alex-sage/pyroPCB/datasheets/arduino_mega_pro_1.webp

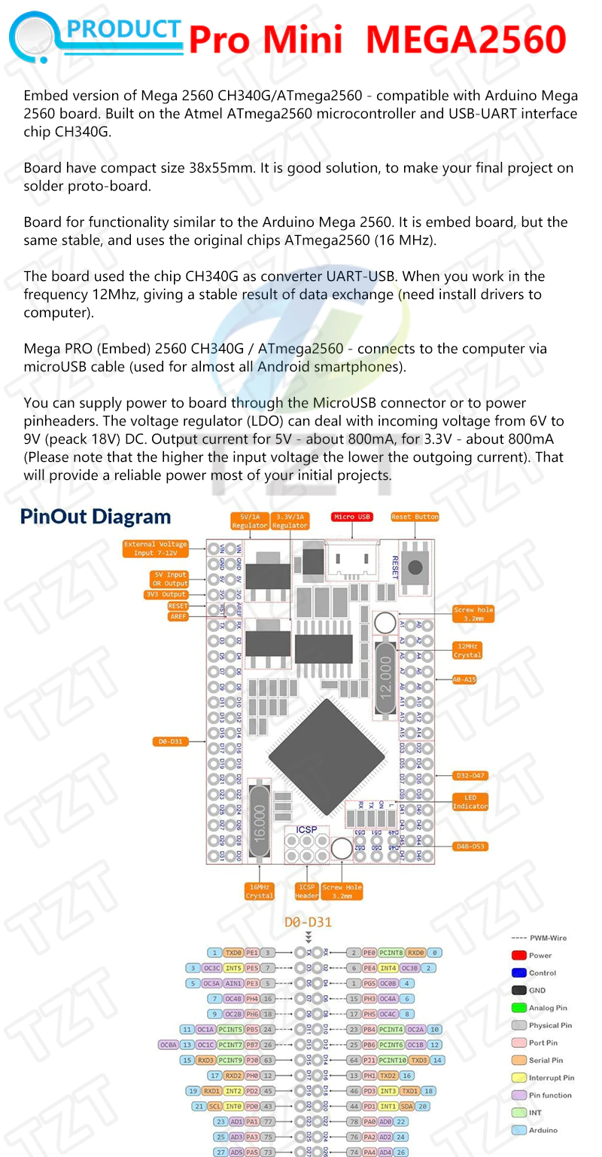
datasheets/arduino_mega_pro_1.webp
