alex-sage/pyroPCB/datasheets/arduino_mega_pro_2.webp

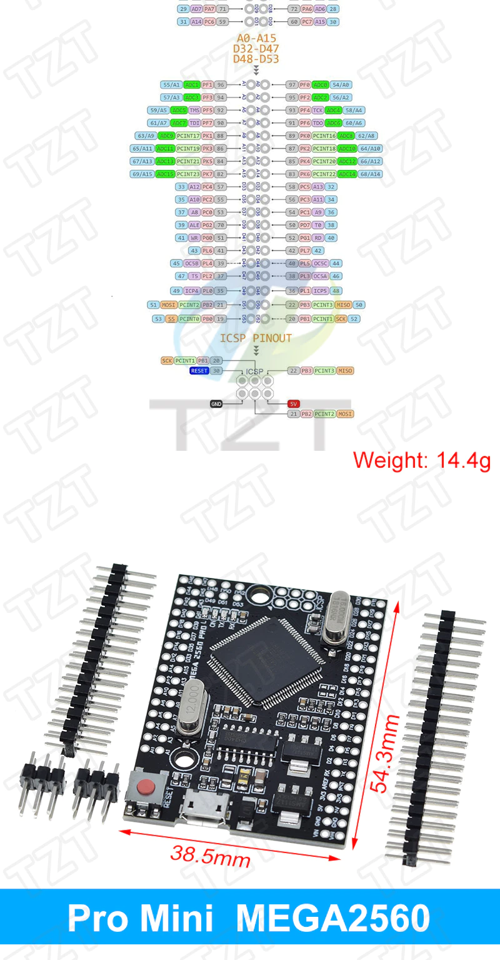
datasheets/arduino_mega_pro_2.webp
