alex-sage/pyroPCB/datasheets/arduino_mega_pro_3.webp

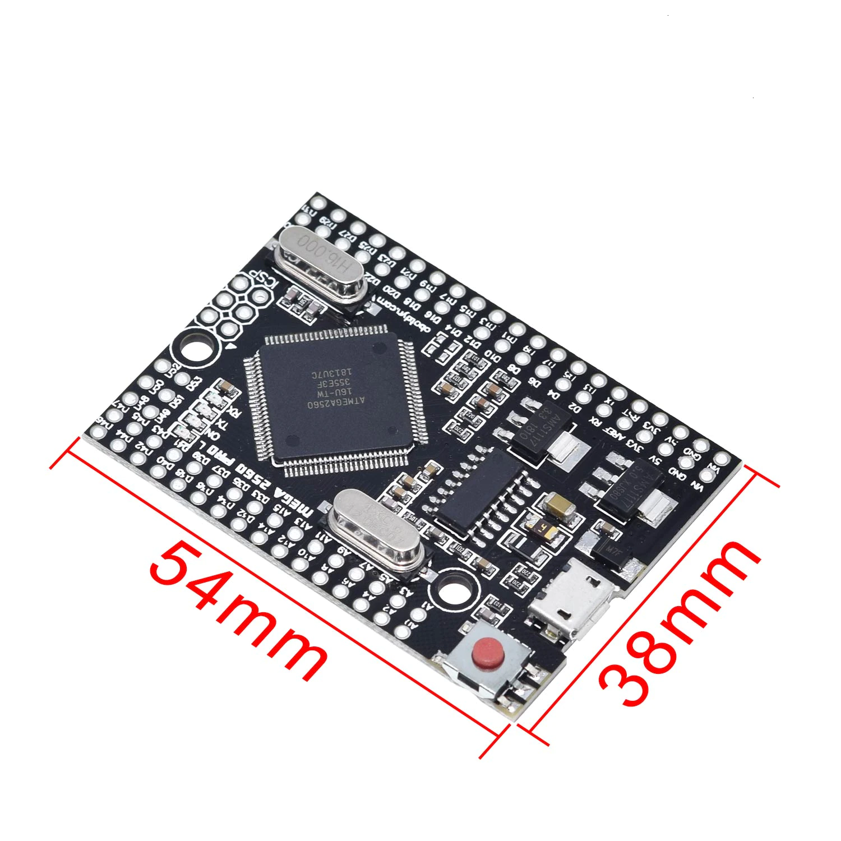
datasheets/arduino_mega_pro_3.webp
