alex-sage/pyroPCB/datasheets/salecom_t-80s_switch.gif

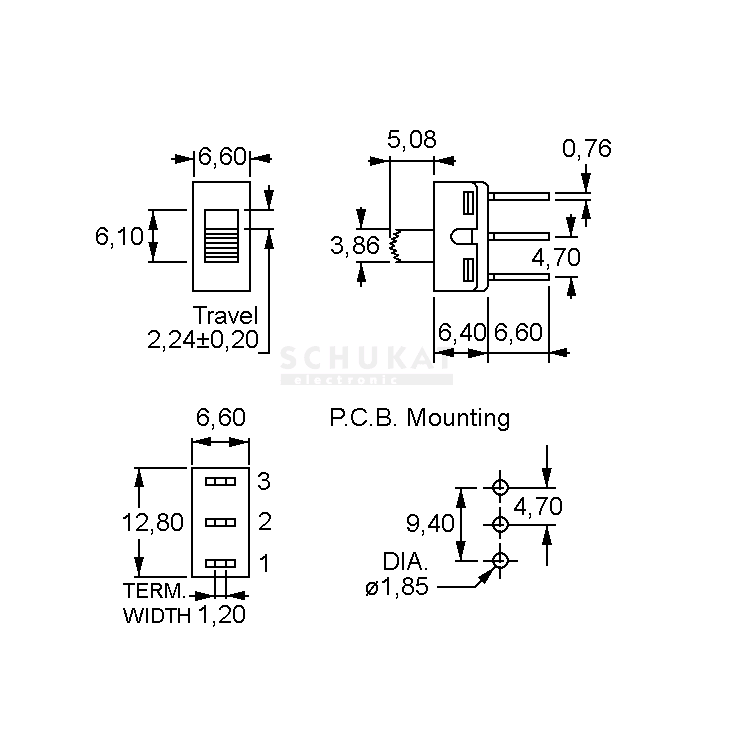
datasheets/salecom_t-80s_switch.gif
