alex-sage/pyroPCB/input-panel/TL1105DF160Q/TL1105DF160Q.step

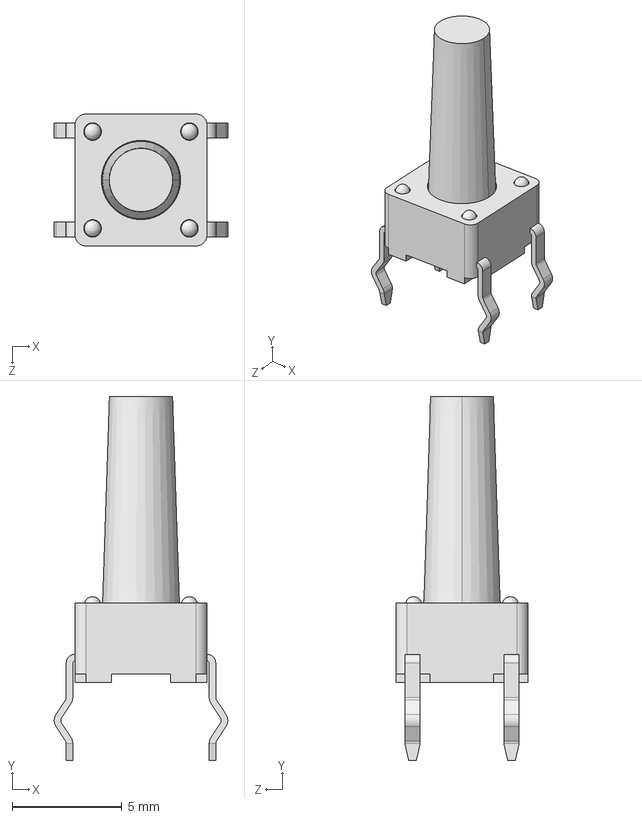
[picture p5: CAD file, 2023-02-28]
input-panel/TL1105DF160Q/TL1105DF160Q.step
7.89 x 16.6 x 6.00 mm
