alex-sage/pyroPCB/pyroDirector/components/cui-2.5mm-jack/CUI_DEVICES_SJ1-2503A.step

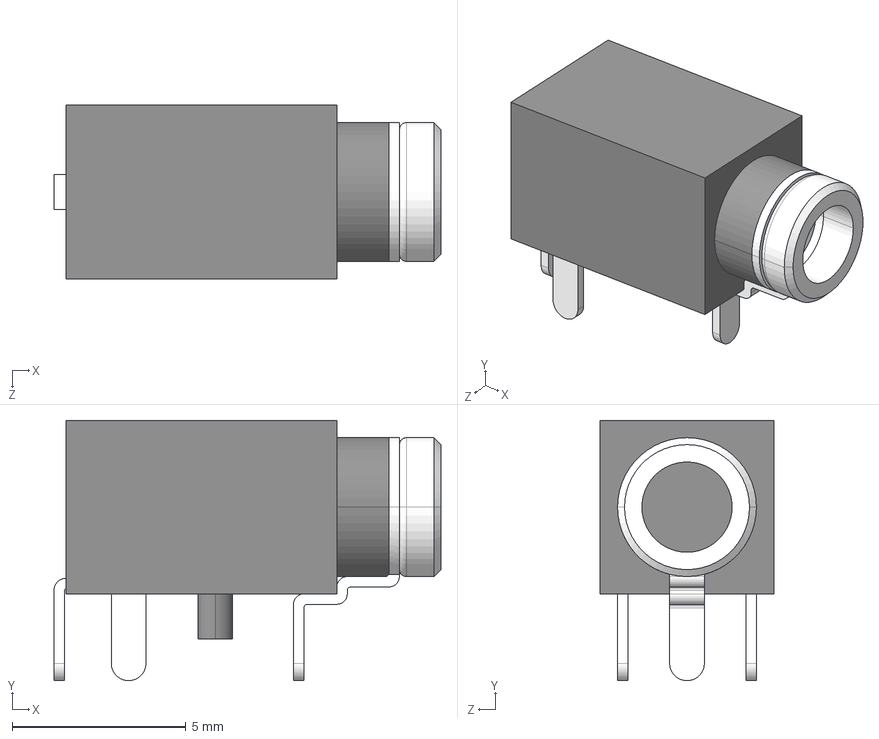
[picture p6: CAD file, 2023-02-11]
pyroDirector/components/cui-2.5mm-jack/CUI_DEVICES_SJ1-2503A.step
11.2 x 7.50 x 5.00 mm
