alex-sage/pyroPCB/pyroDirector/components/cui-3.5mm-3d/CUI_DEVICES_SJ1-3535NG.step

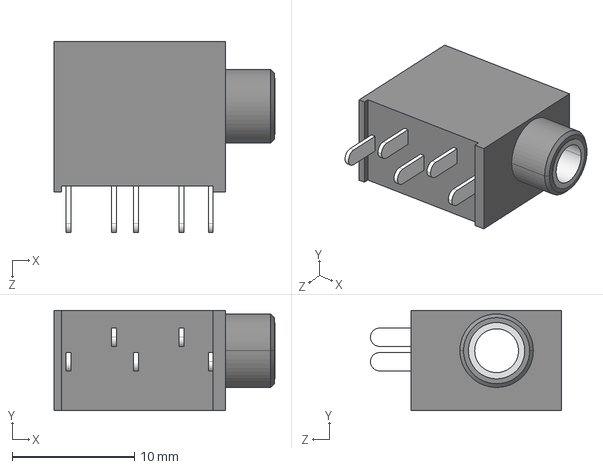
[picture p7: CAD file, 2023-02-11]
pyroDirector/components/cui-3.5mm-3d/CUI_DEVICES_SJ1-3535NG.step
18.1 x 8.20 x 15.6 mm
