alex-sage/pyroPCB/pyroDirector/components/songle-relays/SRD-05VDC-SL-C.step

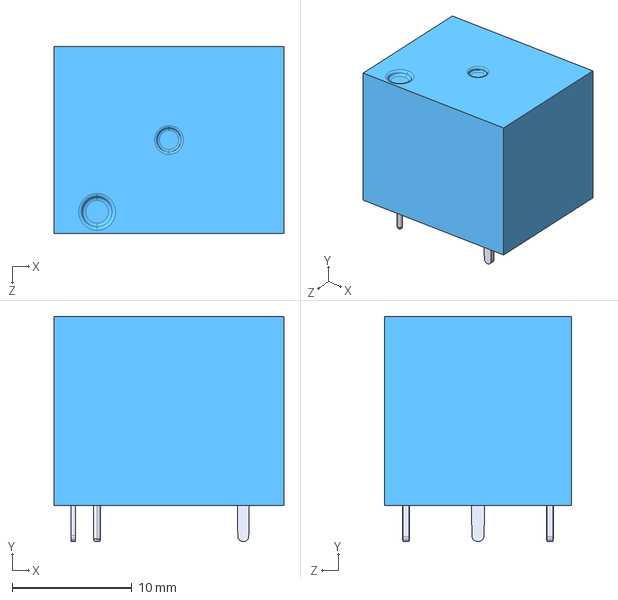
[picture p8: CAD file, 2023-01-26]
pyroDirector/components/songle-relays/SRD-05VDC-SL-C.step
19.2 x 18.8 x 15.6 mm
