alex-sage/pyroPCB/pyroDirector/components/TS-1187A-B-A-B/TS-1187A-B-A-B.step

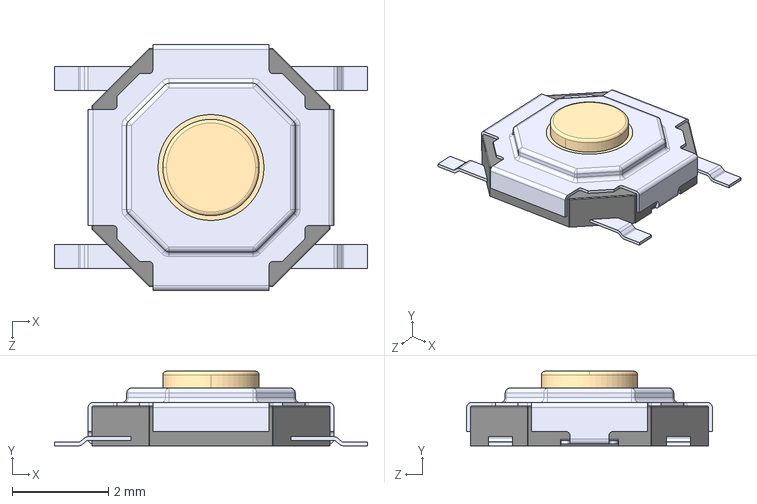
[picture p9: CAD file, 2023-01-26]
pyroDirector/components/TS-1187A-B-A-B/TS-1187A-B-A-B.step
6.50 x 1.55 x 5.10 mm
