alex-sage/pyroPCB/input-panel/TL1105DF160Q/TL1105DF160Q_E-Switch.pdf

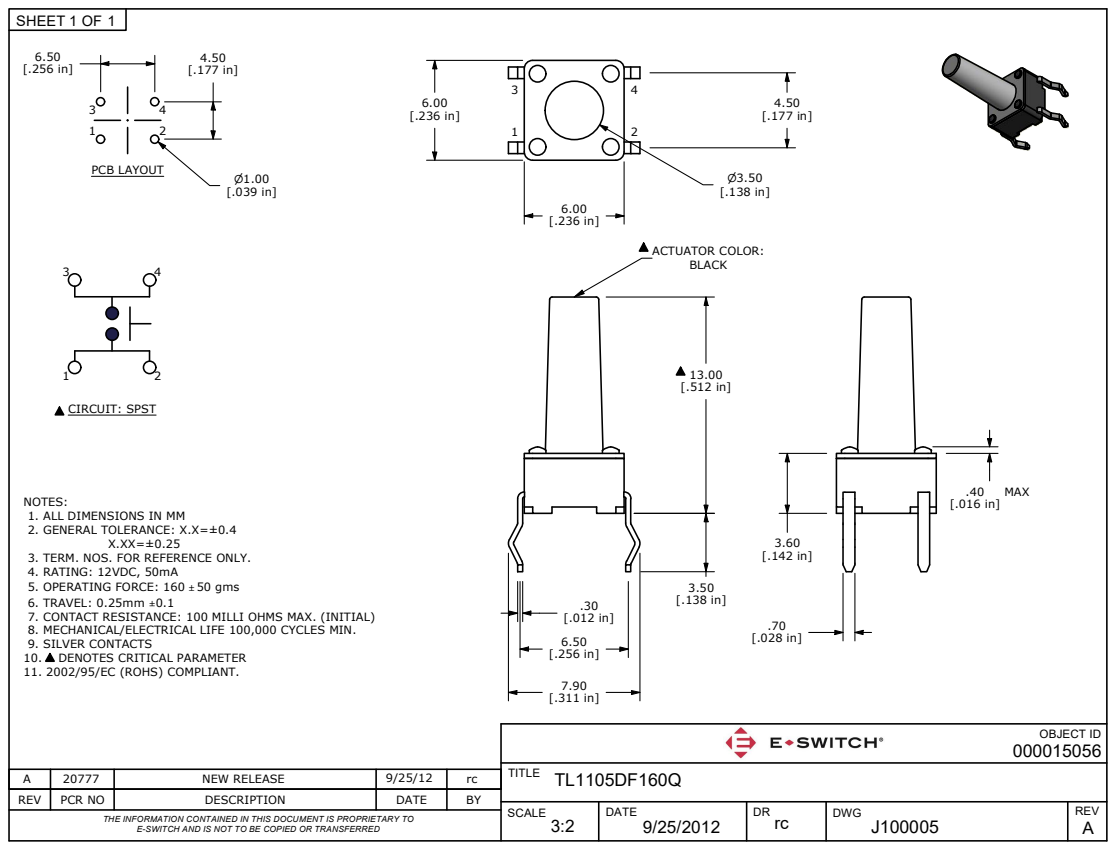
[picture p10: page 1]
REV; PCR NO; DESCRIPTION; DATE; OBJECT ID; PCB LAYOUT; NEW RELEASE; ACTUATOR COLOR:; CIRCUIT: SPST

NOTES:
1. ALL DIMENSIONS IN MM
2. GENERAL TOLERANCE: X.X=±0.4

3. TERM. NOS. FOR REFERENCE ONLY.
4. RATING: 12VDC, 50mA
5. OPERATING FORCE: 160 50 gms
6. TRAVEL: 0.25mm ±0.1
7. CONTACT RESISTANCE: 100 MILLI OHMS MAX. (INITIAL)
8. MECHANICAL/ELECTRICAL LIFE 100,000 CYCLES MIN.
9. SILVER CONTACTS
10. DENOTES CRITICAL PARAMETER
11. 2002/95/EC (ROHS) COMPLIANT.

THE INFORMATION CONTAINED IN THIS DOCUMENT IS PROPRIETARY TO

E-SWITCH AND IS NOT TO BE COPIED OR TRANSFERRED
