alex-sage/pyroPCB/input-panel/input-panel.kicad_pcb

## KiCad design input-panel/input-panel.kicad_pcb (2023-03-01)

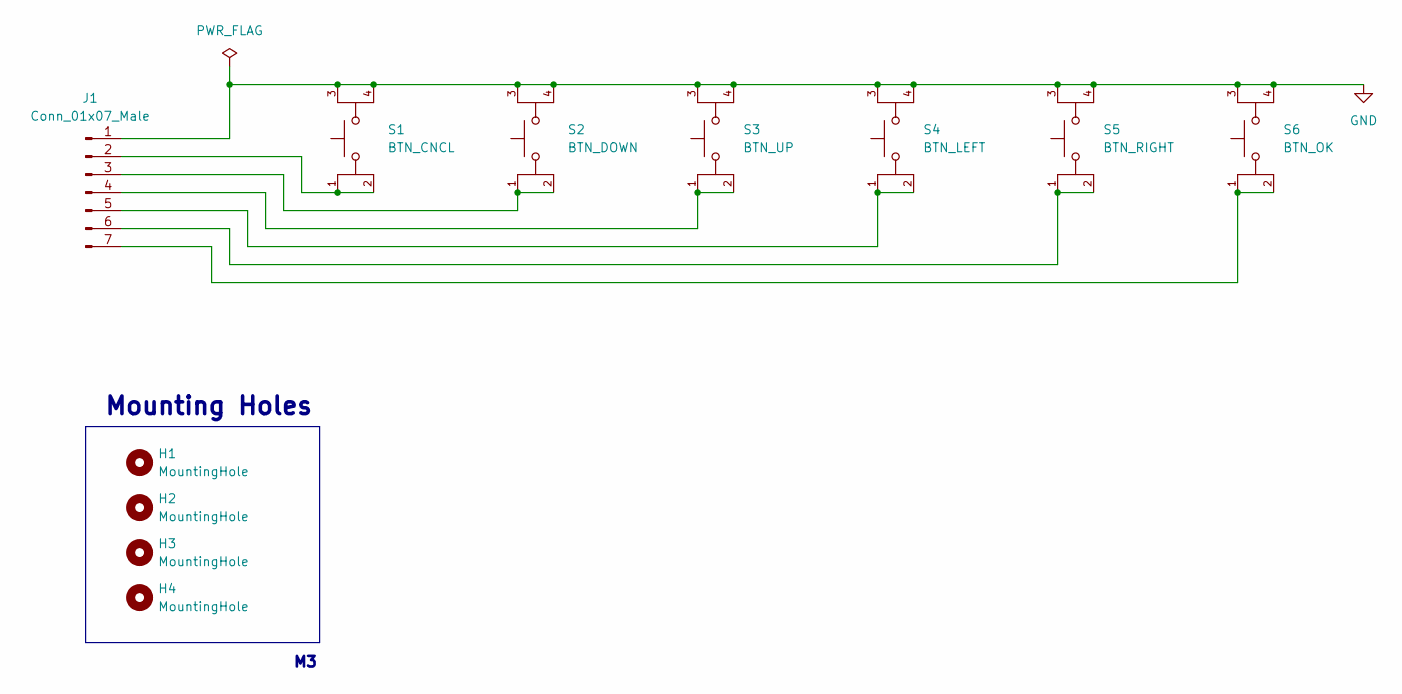
[picture p11: schematic input-panel.kicad_sch]

Parts:
H1, H2, H3, H4: MountingHole; MountingHole_3.2mm_M3
J1: Conn_01x07_Male; PinHeader_1x07_P2.54mm_Vertical
S1: BTN_CNCL; SW_TL1105DF160Q; PARTREV A
S2: BTN_DOWN; SW_TL1105DF160Q; PARTREV A
S3: BTN_UP; SW_TL1105DF160Q; PARTREV A
S4: BTN_LEFT; SW_TL1105DF160Q; PARTREV A
S5: BTN_RIGHT; SW_TL1105DF160Q; PARTREV A
S6: BTN_OK; SW_TL1105DF160Q; PARTREV A

Connections:
GND: J1.1, S1.3, S1.4, S2.3, S2.4, S3.3, S3.4, S4.3, S4.4, S5.3, S5.4, S6.3, S6.4
unnamed: J1.2, S1.1, S1.2
unnamed: J1.3, S2.1, S2.2
unnamed: J1.4, S3.1, S3.2
unnamed: J1.5, S4.1, S4.2
unnamed: J1.6, S5.1, S5.2
unnamed: J1.7, S6.1, S6.2

Notes on the sheet:
Mounting Holes

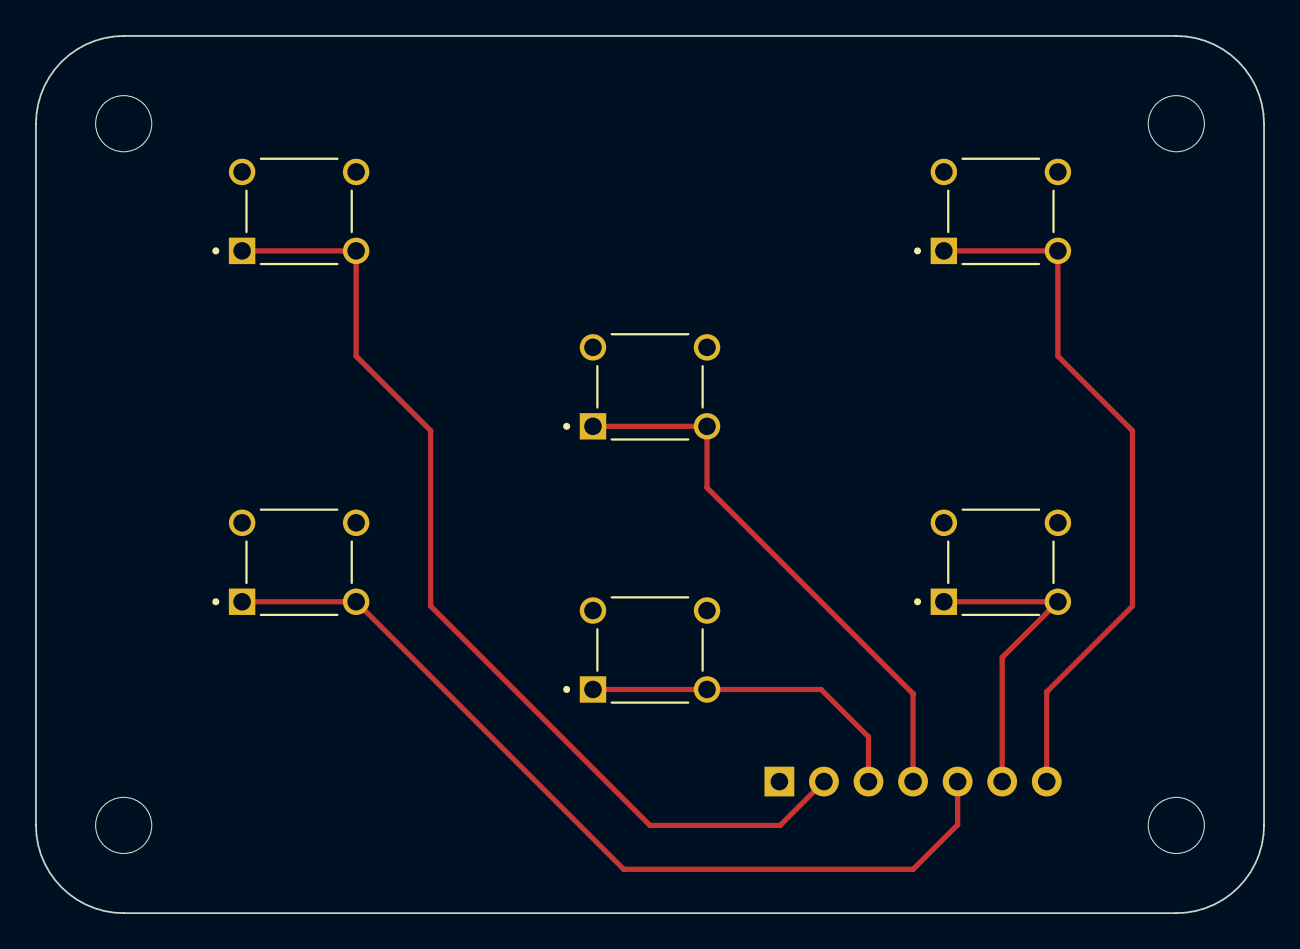
[picture p12: board input-panel.kicad_pcb from above]

Board: 2 copper layers, 70.0 x 50.0 mm, 11 parts (1 on the bottom side), 7 nets.
