alex-sage/pyroPCB/pyroDirector/pyroDirector.kicad_pcb

## KiCad design pyroDirector/pyroDirector.kicad_pcb (2023-02-25)

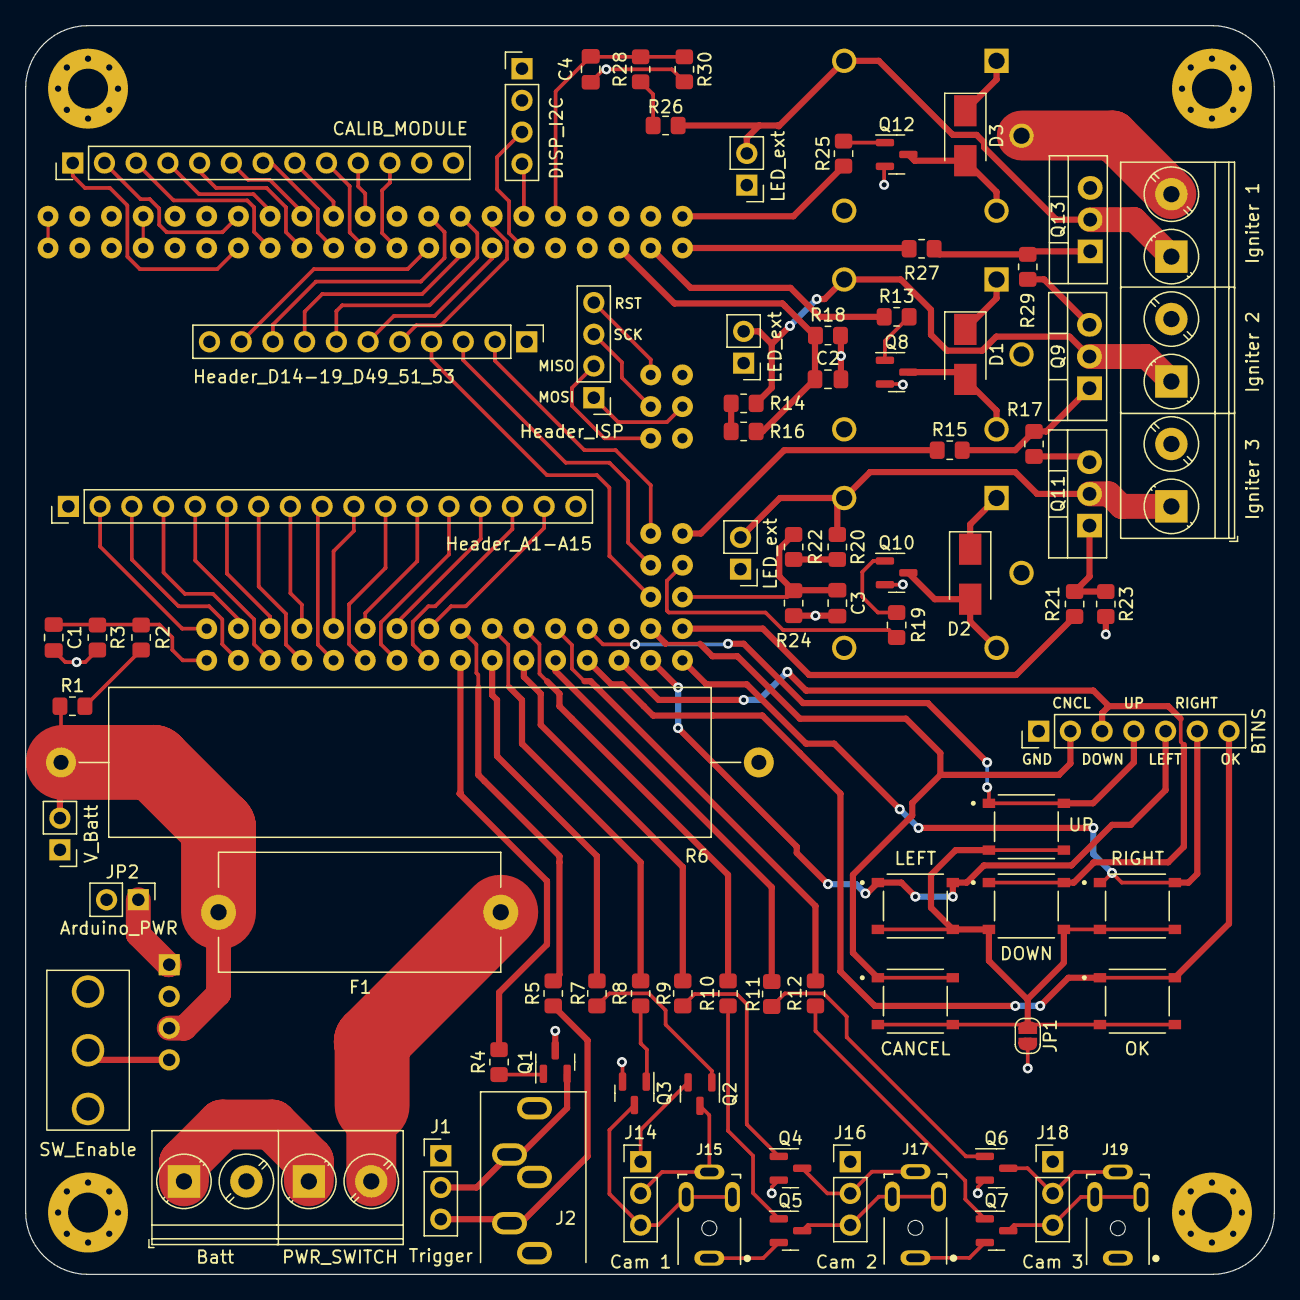
[picture p13: board pyroDirector.kicad_pcb from above]

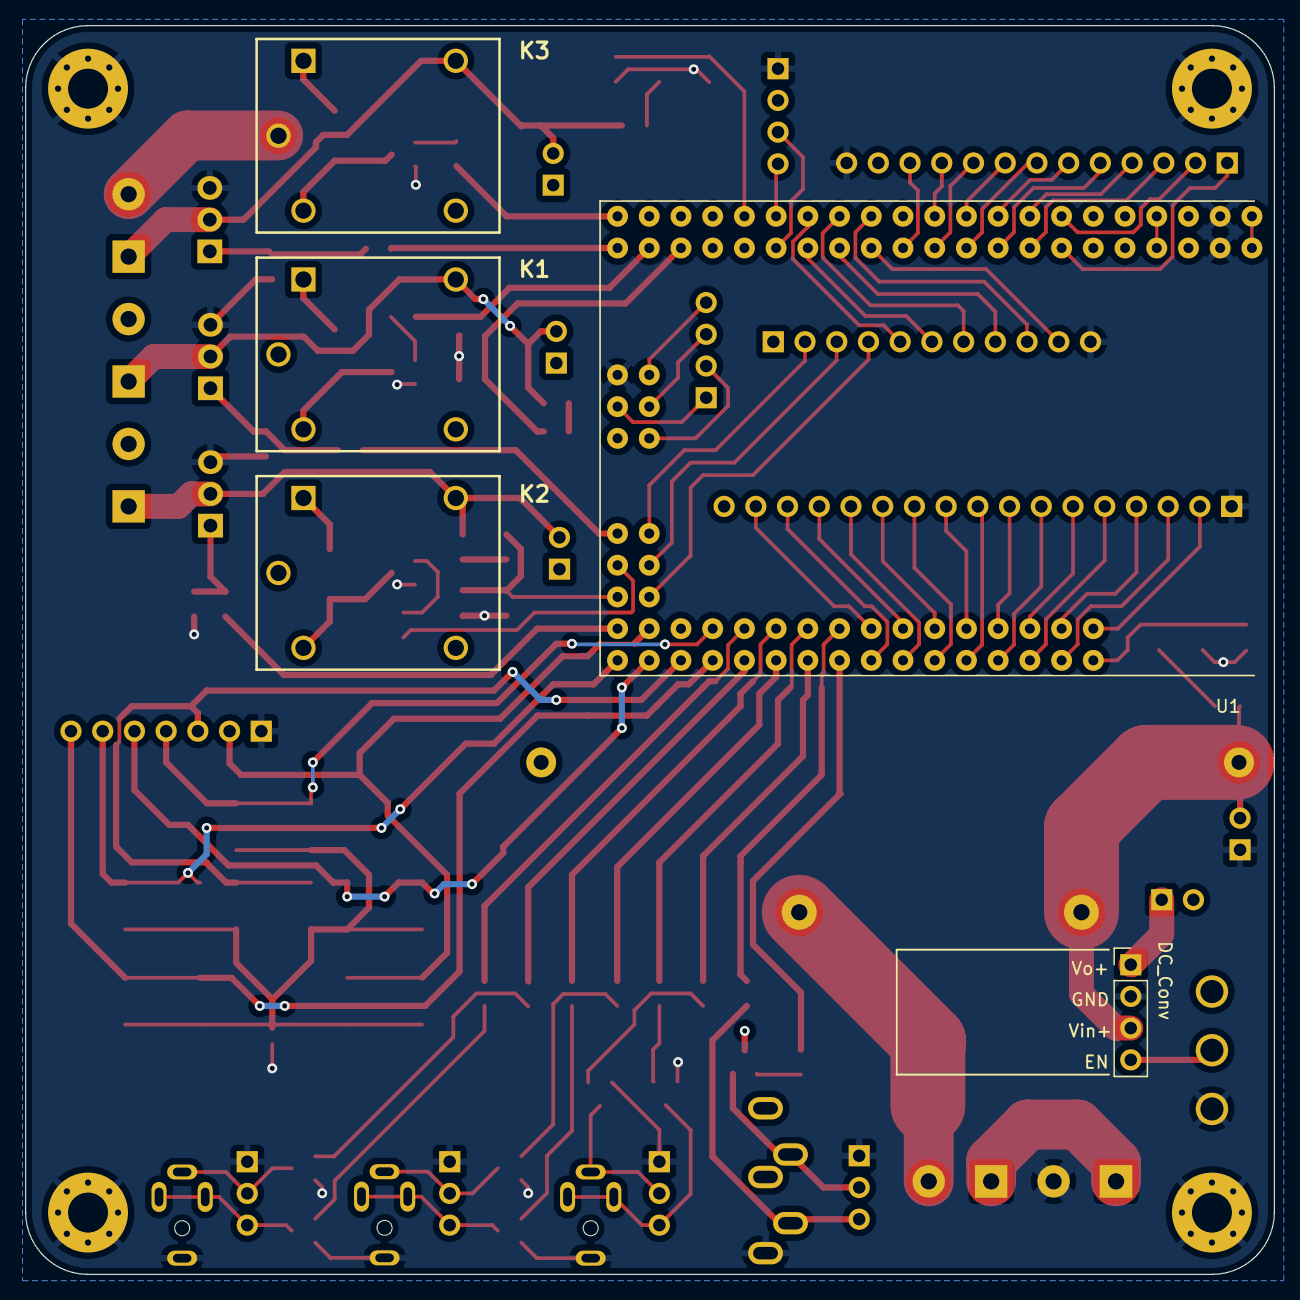
[picture p14: board pyroDirector.kicad_pcb from below]

Board: 4 copper layers, 100.0 x 100.0 mm, 92 parts (5 on the bottom side), 108 nets.

Parts:
C1, C2, C3, C4: 100n; C_0805_2012Metric_Pad1.18x1.45mm_HandSolder
D1, D2, D3: M7; D_SMA
F1: Fuse; Fuseholder_Cylinder-5x20mm_Wuerth_WR-FSH
H1, H2, H3, H4: MountingHole; MountingHole_3.2mm_M3_Pad_Via
J1, J14, J16, J18: Conn_01x03_Male; PinHeader_1x03_P2.54mm_Vertical
J2: AudioJack3.5mm; Jack_3.5mm_CUI_SJ1-3535NG_Horizontal
J3: Header_A1-A15; PinHeader_1x17_P2.54mm_Vertical
J4: Header_D14-19_D49_51_53; PinHeader_1x11_P2.54mm_Vertical
J6: V_Batt; PinHeader_1x02_P2.54mm_Vertical
J7: Header_ISP; PinHeader_1x04_P2.54mm_Vertical
J8: PWR_SWITCH; TerminalBlock_Phoenix_PT-1,5-2-5.0-H_1x02_P5.00mm_Horizontal
J9: Batt; TerminalBlock_Phoenix_PT-1,5-2-5.0-H_1x02_P5.00mm_Horizontal
J10: BTNS; PinHeader_1x07_P2.54mm_Vertical
J11: DC_Conv; PinHeader_1x04_P2.54mm_Vertical
J12: CALIB_MODULE; PinHeader_1x13_P2.54mm_Vertical
J13: DISP_I2C; PinHeader_1x04_P2.54mm_Vertical
J15, J17, J19: SJ1-2503A; CUI_SJ1-2503A
J20, J22, J24: LED_ext; PinHeader_1x02_P2.54mm_Vertical
J21, J23, J25: Screw_Terminal_01x02; TerminalBlock_Phoenix_PT-1,5-2-5.0-H_1x02_P5.00mm_Horizontal
JP1: Enable_PCB_Buttons; SolderJumper-2_P1.3mm_Open_RoundedPad1.0x1.5mm
JP2: Arduino_PWR; PinHeader_1x02_P2.54mm_Vertical
K1, K2, K3: PR12-5V-360-1C
Q1, Q2, Q3, Q4, Q5, Q6, Q7, Q8, Q10, Q12: MMBT2222A 1P; SOT-23
Q9, Q11, Q13: IRLB8721PbF; TO-220-3_Vertical
R1, R2, R3, R14, R16, R18, R20, R22, R24, R26, R28, R30: 1M; R_0805_2012Metric_Pad1.20x1.40mm_HandSolder
R4, R5, R7, R8, R9, R10, R11, R12, R13, R19, R25: 4k7; R_0805_2012Metric_Pad1.20x1.40mm_HandSolder
R6: 1R; R_Axial_Power_L48.0mm_W10mm_P55.88mm
R15, R21, R27: 100R; R_0805_2012Metric_Pad1.20x1.40mm_HandSolder
R17, R23, R29: 47k; R_0805_2012Metric_Pad1.20x1.40mm_HandSolder
S1: PCB_Btn_Cncl; SW_TS-1187A-B-A-B
S2: PCB_Btn_-; SW_TS-1187A-B-A-B
S3: PCB_Btn_+; SW_TS-1187A-B-A-B
S4: PCB_Btn_LEFT; SW_TS-1187A-B-A-B
S5: PCB_Btn_RIGHT; SW_TS-1187A-B-A-B
S6: PCB_Btn_OK; SW_TS-1187A-B-A-B
SW1: SW_Enable; Saleforce_T80-S_TS-13_Slide_Switch
U1: MEGA_PRO_ATMEGA2560; MODULE_MEGA_PRO_EMBED_CH340G___ATMEGA2560

Connections:
12V_LTD: J20.1, J22.1, J24.1, K1.NO, K2.NO, K3.NO, R6.2
+5V: D1.1 (K), D2.1 (K), D3.1 (K), J3.17, J4.1, J12.12, J13.2, JP2.2 (B), K1.A1 (Coil_1), K2.A1 (Coil_1), K3.A1 (Coil_1), Q1.3 (C), U1.5V_1 (5V), U1.5V_2 (5V), U1.5V_3 (5V)
+12V: F1.2, J6.2, J11.3, R1.1, R6.1
/A1: J3.2, U1.A1
/A2: J3.3, U1.A2
/A3: J3.4, U1.A3
/A4: J3.5, U1.A4
/A5: J3.6, U1.A5
/A6: J3.7, U1.A6
/A7: J3.8, U1.A7
/A8: J3.9, U1.A8
/A9: J3.10, U1.A9
/A10: J3.11, U1.A10
/A11: J3.12, U1.A11
/A12: J3.13, U1.A12
/A13: J3.14, U1.A13
/A14: J3.15, U1.A14
/A15: J3.16, U1.A15
/BATT_SENSE: C1.1, R2.2, R3.1, U1.A0
/BTN_CNCL: J10.2, S1.A, S1.B, U1.D45
/BTN_DOWN: J10.3, S2.A, S2.B, U1.D42
/BTN_LEFT: J10.5, S4.A, S4.B, U1.D44
/BTN_OK: J10.7, S6.A, S6.B, U1.D40
/BTN_RIGHT: J10.6, S5.A, S5.B, U1.D46
/BTN_UP: J10.4, S3.A, S3.B, U1.D41
/D14: J4.10, U1.D14
/D15: J4.9, U1.D15
/D16: J4.8, U1.D16
/D17: J4.7, U1.D17
/D18: J4.6, U1.D18
/D19: J4.5, U1.D19
/D49: J4.4, U1.D49
/D51: J4.3, U1.D51
/D53: J4.2, U1.D53
/DISP_SCL: J13.4, U1.D21
/DISP_SDA: J13.3, U1.D20
/EN: J11.4, SW1.2 (B)
/FIRE_0: R27.1, U1.D30
/FIRE_1: R15.1, U1.D52
/FIRE_2: R21.1, U1.D47
/LED_1: J12.1, U1.D2
/LED_2: J12.2, U1.D3
/LED_3: J12.3, U1.D4
/LED_4: J12.4, U1.D5
/LED_5: J12.5, U1.D6
/LED_6: J12.6, U1.D7
/LED_7: J12.7, U1.D8
/LED_8: J12.8, U1.D9
/LED_9: J12.9, U1.D10
/LED_10: J12.10, U1.D11
/LED_G: J12.11, U1.D12
/MISO: J7.2, U1.MISO
/MOSI: J7.1, U1.MOSI
/PRE_CAM_0: R7.1, U1.D34
/PRE_CAM_1: R9.1, U1.D36
/PRE_CAM_2: R11.1, U1.D38
/PRIME_0: R25.1, U1.D31
/PRIME_1: R13.1, U1.D28
/PRIME_2: R19.1, U1.D50
/RST: J7.4, U1.RESET
/SCK: J7.3, U1.SCK
/SENSE_0: C4.1, R28.2, R30.1, U1.D23
/SENSE_1: C2.1, R16.2, R18.1, U1.D26
/SENSE_2: C3.1, R22.2, R24.1, U1.D48
/SHUTTER_CAM_0: R8.2, U1.D35
/SHUTTER_CAM_1: R10.2, U1.D37
/SHUTTER_CAM_2: R12.2, U1.D39
/TRIGGER: R5.2, U1.D33
/TRIGGER_LED: R4.2, U1.D32
/VO+: J11.1, JP2.1 (A)
GND: C1.2, C2.2, C3.2, C4.2, H1.1, H2.1, H3.1, H4.1, J1.1, J2.S, J3.1, J4.11, J6.1, J9.2, J10.1, J11.2, J12.13, J13.1, J14.1, J15.1, J16.1, J17.1, J18.1, J19.1, JP1.2 (B), Q2.2 (E), Q3.2 (E), Q4.2 (E), Q5.2 (E), Q6.2 (E), Q7.2 (E), Q8.2 (E), Q9.3 (S), Q10.2 (E), Q11.3 (S), Q12.2 (E), Q13.3 (S), R3.2, R17.2, R18.2, R23.2, R24.2, R29.2, R30.2, SW1.3 (C), U1.GND_1 (GND), U1.GND_2 (GND), U1.GND_3 (GND)
unnamed: D1.2 (A), K1.A2 (Coil_2), Q8.3 (C)
unnamed: D2.2 (A), K2.A2 (Coil_2), Q10.3 (C)
unnamed: D3.2 (A), K3.A2 (Coil_2), Q12.3 (C)
unnamed: F1.1, J8.2
unnamed: J1.2, J2.R, Q1.2 (E)
unnamed: J1.3, J2.T, R5.1
unnamed: J8.1, J9.1
unnamed: J14.2, J15.4, Q2.3 (C)
unnamed: J14.3, J15.2, J15.3, Q3.3 (C)
unnamed: J16.2, J17.4, Q4.3 (C)
unnamed: J16.3, J17.2, J17.3, Q5.3 (C)
unnamed: J18.2, J19.4, Q6.3 (C)
unnamed: J18.3, J19.2, J19.3, Q7.3 (C)
unnamed: J20.2, J21.1, K1.NC, Q9.2 (D), R14.1
unnamed: J21.2, K1.COM
unnamed: J22.2, J23.1, K2.NC, Q11.2 (D), R20.1
unnamed: J23.2, K2.COM
unnamed: J24.2, J25.1, K3.NC, Q13.2 (D), R26.1
unnamed: J25.2, K3.COM
unnamed: JP1.1 (A), S1.C, S1.D, S2.C, S2.D, S3.C, S3.D, S4.C, S4.D, S5.C, S5.D, S6.C, S6.D
unnamed: Q1.1 (B), R4.1
unnamed: Q2.1 (B), R7.2
unnamed: Q3.1 (B), R8.1
unnamed: Q4.1 (B), R9.2
unnamed: Q5.1 (B), R10.1
unnamed: Q6.1 (B), R11.2
unnamed: Q7.1 (B), R12.1
unnamed: Q8.1 (B), R13.2
unnamed: Q9.1 (G), R15.2, R17.1
unnamed: Q10.1 (B), R19.2
unnamed: Q11.1 (G), R21.2, R23.1
unnamed: Q12.1 (B), R25.2
unnamed: Q13.1 (G), R27.2, R29.1
unnamed: R1.2, R2.1
unnamed: R14.2, R16.1
unnamed: R20.2, R22.1
unnamed: R26.2, R28.1
