alex-sage/pyroPCB/led-counter/led-counter.kicad_pcb

## KiCad design led-counter/led-counter.kicad_pcb (2023-01-26)

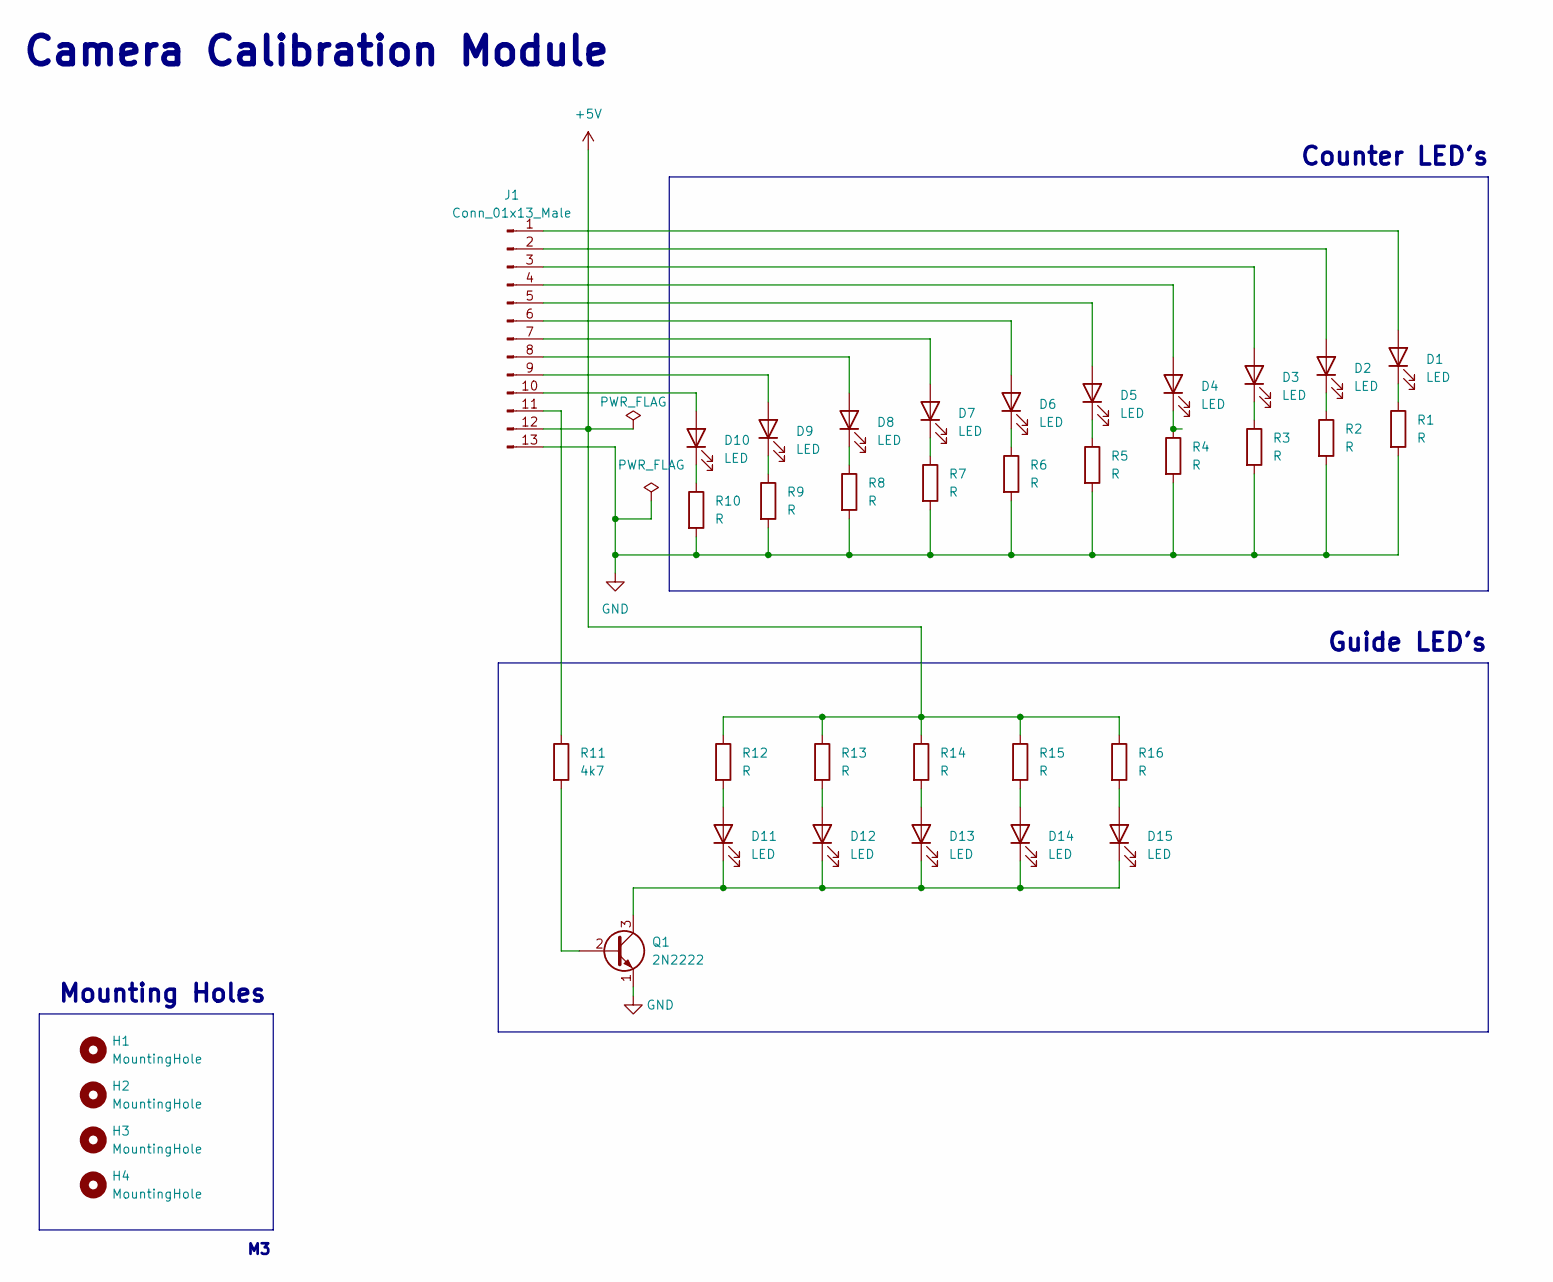
[picture p15: schematic led-counter.kicad_sch, Camera Calibration Module (LED Counter)]

Parts:
D1, D2, D3, D4, D5, D6, D7, D8, D9, D10, D11, D12, D13, D14, D15: LED; LED_D5.0mm
H1, H2, H3, H4: MountingHole; MountingHole_3.2mm_M3
J1: Conn_01x13_Male; PinHeader_1x13_P2.54mm_Vertical
Q1: 2N2222; TO-92
R1, R2, R3, R4, R5, R6, R7, R8, R9, R10, R12, R13, R14, R15, R16: R; R_Axial_DIN0204_L3.6mm_D1.6mm_P7.62mm_Horizontal
R11: 4k7; R_Axial_DIN0204_L3.6mm_D1.6mm_P7.62mm_Horizontal

Connections:
+5V: J1.12, R12.1, R13.1, R14.1, R15.1, R16.1
GND: J1.13, Q1.1 (E), R1.2, R2.2, R3.2, R4.2, R5.2, R6.2, R7.2, R8.2, R9.2, R10.2
unnamed: D1.1 (K), R1.1
unnamed: D1.2 (A), J1.1
unnamed: D2.1 (K), R2.1
unnamed: D2.2 (A), J1.2
unnamed: D3.1 (K), R3.1
unnamed: D3.2 (A), J1.3
unnamed: D4.1 (K), R4.1
unnamed: D4.2 (A), J1.4
unnamed: D5.1 (K), R5.1
unnamed: D5.2 (A), J1.5
unnamed: D6.1 (K), R6.1
unnamed: D6.2 (A), J1.6
unnamed: D7.1 (K), R7.1
unnamed: D7.2 (A), J1.7
unnamed: D8.1 (K), R8.1
unnamed: D8.2 (A), J1.8
unnamed: D9.1 (K), R9.1
unnamed: D9.2 (A), J1.9
unnamed: D10.1 (K), R10.1
unnamed: D10.2 (A), J1.10
unnamed: D11.1 (K), D12.1 (K), D13.1 (K), D14.1 (K), D15.1 (K), Q1.3 (C)
unnamed: D11.2 (A), R12.2
unnamed: D12.2 (A), R13.2
unnamed: D13.2 (A), R14.2
unnamed: D14.2 (A), R15.2
unnamed: D15.2 (A), R16.2
unnamed: J1.11, R11.1
unnamed: Q1.2 (B), R11.2

Notes on the sheet:
Guide LED's
Camera Calibration Module
Mounting Holes
Counter LED's

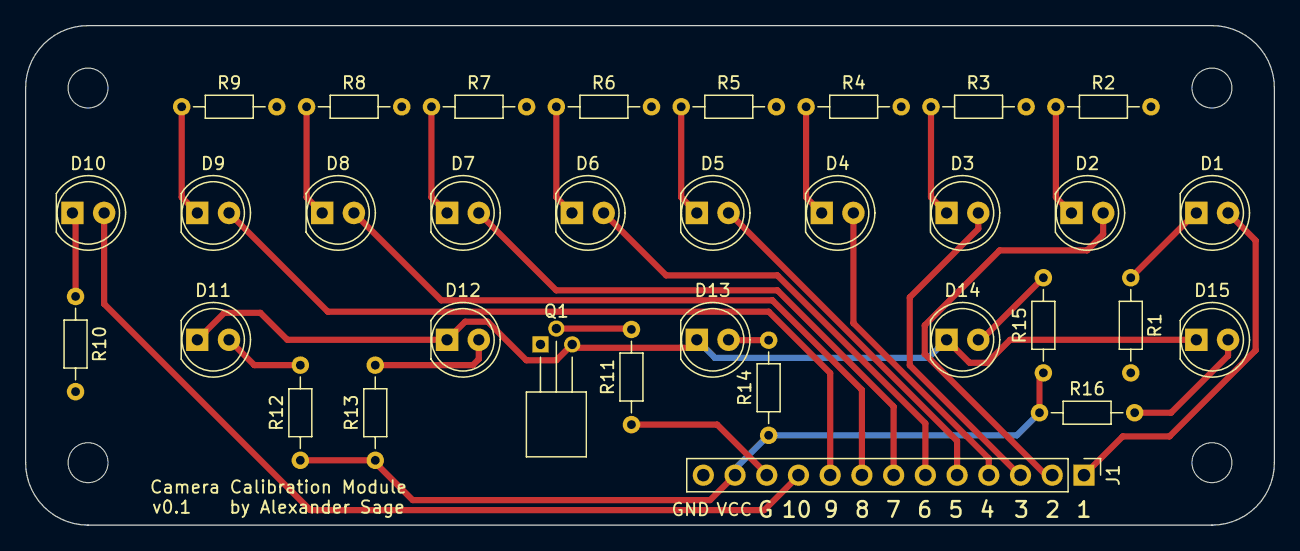
[picture p16: board led-counter.kicad_pcb from above]

Board: 2 copper layers, 100.0 x 40.0 mm, 37 parts (0 on the bottom side), 30 nets.
