alex-sage/pyroPCB/(commit log)

2023-01-26 initial commit for main PCB
    [SRD-05VDC-SL-C.step, TS-1187A-B-A-B.step, camera.kicad_sch, igniter.kicad_sch, pyroDirector.kicad_pcb, pyroDirector.kicad_sch]
2023-01-26 initial commit for LED counter
    [led-counter-B_Cu.gbr, led-counter-B_Mask.gbr, led-counter-B_Paste.gbr, led-counter-B_Silkscreen.gbr, led-counter-Edge_Cuts.gbr, led-counter-F_Cu.gbr, led-counter-F_Mask.gbr, led-counter-F_Paste.gbr]
2023-01-30 Added jacks and PCB switch
    [camera.kicad_sch, igniter.kicad_sch, pyroDirector.kicad_sch]
2023-02-05 first component placement, trigger header is missing!
    [camera.kicad_sch, igniter.kicad_sch, pyroDirector.kicad_pcb, pyroDirector.kicad_sch]
2023-02-10 placement improvements, added missing header -->should we use handsolder pads?
    [camera.kicad_sch, igniter.kicad_sch, pyroDirector.kicad_pcb, pyroDirector.kicad_sch]
2023-02-11 placement & 3-D models complete
    [CUI_DEVICES_SJ1-2503A.step, CUI_DEVICES_SJ1-3535NG.step, pyroDirector.kicad_pcb, pyroDirector.kicad_sch]
2023-02-12 layout in progress
    [pyroDirector.kicad_pcb, pyroDirector.kicad_sch]
2023-02-25 final design
    [pyroDirector.kicad_pcb]
2023-02-25 Manufactured 2021-02-25
    [camera.kicad_sch, igniter.kicad_sch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]
2023-02-28 added input panel project
    [TL1105DF160Q.step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]
2023-03-01 re-designed input panel PCB
    [input-panel-B_Cu.gbr, input-panel-B_Mask.gbr, input-panel-B_Paste.gbr, input-panel-B_Silkscreen.gbr, input-panel-Edge_Cuts.gbr, input-panel-F_Cu.gbr, input-panel-F_Mask.gbr, input-panel-F_Paste.gbr]
2024-01-21 replaced trigger transistor with PNP variant
    [pyroDirector.kicad_sch]
